Cptmeme/Nanoleaf-Shapes-controller/hardware/render/rev-b-bottom.png

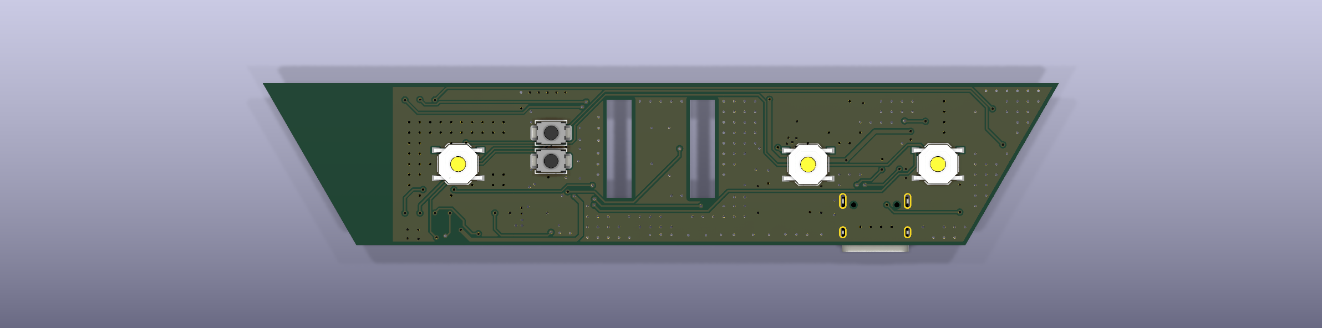
hardware/render/rev-b-bottom.png
