Cptmeme/Nanoleaf-Shapes-controller/hardware/render/rev-b-iso.png

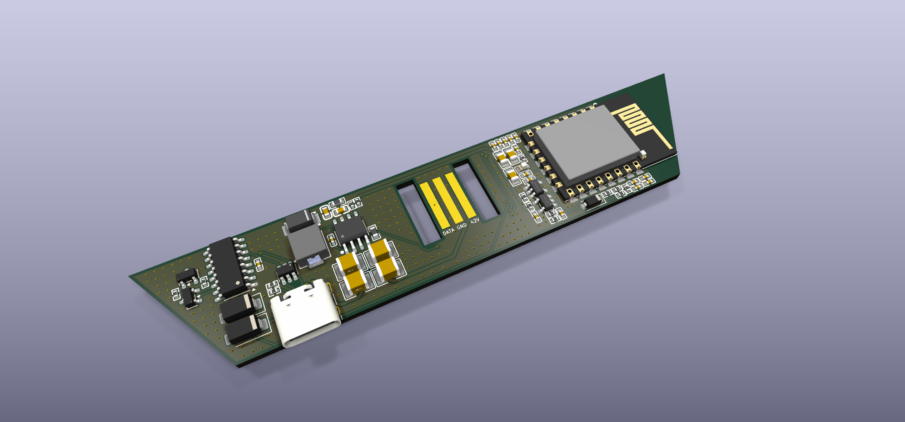
hardware/render/rev-b-iso.png
