Cptmeme/Nanoleaf-Shapes-controller/hardware/render/rev-b-top.png

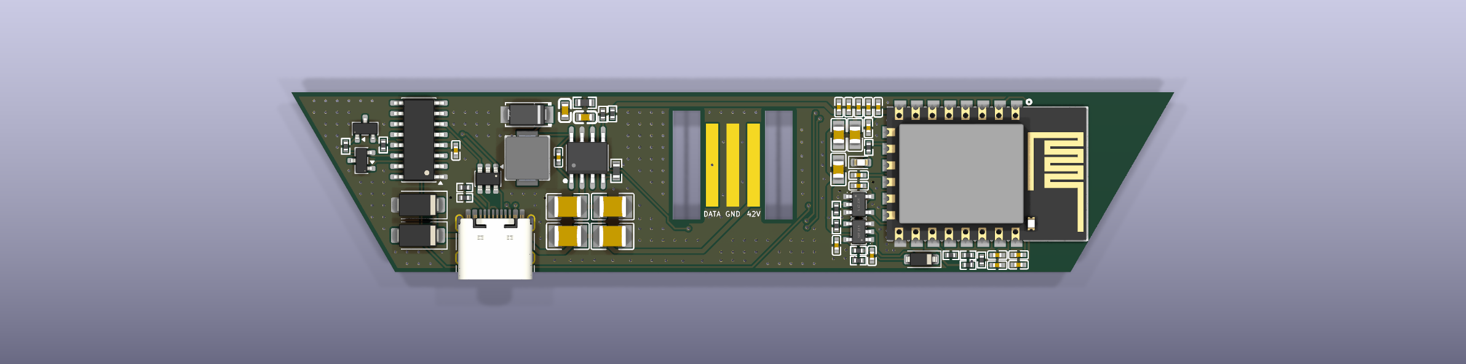
hardware/render/rev-b-top.png
