Cptmeme/Nanoleaf-Shapes-controller/hardware/fab/pcbway/bom_pcbway.xlsx

Item # | Designator | Qty | Manufacturer Part Number | Manufacturer | Description / Value | Package / Footprint | Type | Supplier | Supplier Part Number | Your Instructions / Notes
1 | C1,C2,C3,C11 | 4 |  |  | 2.2uF 100V | C1210 | SMD | LCSC | C5449052
2 | C4,C5,C6,C7,C8,C9,C10,C18,C19,C20,C22,C23,C24,C26 | 14 |  |  | 100nF 16V | C0402 | SMD | LCSC | C1525
3 | C12 | 1 |  |  | 330pF | C0603 | SMD | LCSC | C1664
4 | C13 | 1 |  |  | 47nF | C0603 | SMD | LCSC | C1622
5 | C14,C15,C16 | 3 |  |  | 22uF 25V | C0805 | SMD | LCSC | C45783
6 | C17 | 1 |  |  | 220pF | C0402 | SMD | LCSC | C1530
7 | C21 | 1 |  |  | 1uF | C0402 | SMD | LCSC | C52923
8 | D1,D5 | 2 | SS210 | MDD | 100V/2A Schottky | SMA_L4.3-W2.6-LS5.2-RD | SMD | LCSC | C14996
9 | D2 | 1 |  |  | D | D_SOD-123 | SMD | LCSC | C81598
10 | D3 | 1 | SMAJ48A | LRC | SMAJ48A | D_SMA | SMD | LCSC | C41376401
11 | D4 | 1 | KT-0603W | Hubei KENTO Elec | LED | LED_0603_1608Metric | SMD | LCSC | C2290
12 | J3 | 1 | TYPE-C-31-M-12 | Korean Hroparts Elec | USB_C_Receptacle_USB2.0_16P | USB_C_Receptacle_HRO_TYPE-C-31-M-12 | THT | LCSC | C165948
13 | L1 | 1 |  |  | 33uH >2A sat | IND-SMD_L5.2-W5.2_YSPI0530 | SMD | LCSC | C20417191
14 | Q1,Q2 | 2 | MMBT3904 | Jiangsu Changjing | MMBT3904 | SOT-23 | SMD | LCSC | C7420353
15 | R1 | 1 |  |  | 2.2k | R0402 | SMD | LCSC | C25879
16 | R6,R10,R17 | 3 |  |  | 1k | R0402 | SMD | LCSC | C11702
17 | R11,R12 | 2 | 0402WGF5101TCE | UNI-ROYAL | 5.1k | R0402 | SMD | LCSC | C25905
18 | R7,R9,R13,R14,R16 | 5 |  |  | 10k | R0402 | SMD | LCSC | C25744
19 | R15 | 1 | 0402WGF1003TCE | UNI-ROYAL | 100k | R0402 | SMD | LCSC | C25741
20 | R2 | 1 |  |  | 47k | R0402 | SMD | LCSC | C25792
21 | R3 | 1 |  |  | 15k | R0402 | SMD | LCSC | C25756
22 | R4 | 1 |  |  | 3k | R0603 | SMD | LCSC | C4211
23 | R5 | 1 |  |  | 330k | R0603 | SMD | LCSC | C23137
24 | R8 | 1 |  |  | 220 | R0402 | SMD | LCSC | C25091
25 | SW1,SW2 | 2 | TS-1088-AR02016 | XUNPU(讯普) | RESET | SW_SPST_TS-1088-xR020 | SMD | LCSC | C720477
26 | SW3,SW4,SW6 | 3 | TS-1187A-B-A-B | XKB Enterprise | USER BUTTON | SW_Push_1P1T_XKB_TS-1187A | SMD | LCSC | C318884
27 | U1 | 1 | TPS54360DDAR | TI(德州仪器) | TPS54360DDAR | SOIC-8_L5.0-W4.0-P1.27-LS6.0-BL-EP2.0 | SMD | LCSC | C44377
28 | U2 | 1 | ESPC5-12 | DOIT | ESPC5-12 | WT0132C6-S5 | SMD | LCSC | C52139916
29 | U3,U4 | 2 | 74LVC1G125GV | MDD(辰达半导体) | 74LVC1G125GV_C52140413 | SOT-23-5_L3.0-W1.7-P0.95-LS2.8-BR | SMD | LCSC | C52140413
30 | U5 | 1 | CH340C | WCH(Jiangsu Qin Heng) | CH340C | SOIC-16_3.9x9.9mm_P1.27mm | SMD | LCSC | C84681
31 | U6 | 1 | USBLC6-2SC6 | Hgsemi | USBLC6-2SC6 | SOT-23-6 | SMD | LCSC | C2827654
