Cptmeme/Nanoleaf-Shapes-controller/hardware/mechanical/board_mock_full.stl

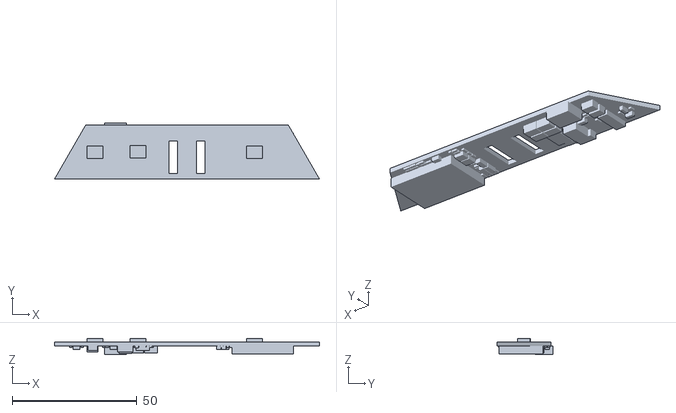
[picture p10: CAD file, 2026-10-17]
hardware/mechanical/board_mock_full.stl
106.3 x 22.5 x 6.60
