Cptmeme/Nanoleaf-Shapes-controller/hardware/mechanical/case_v1_working/enclosure_lid.stl

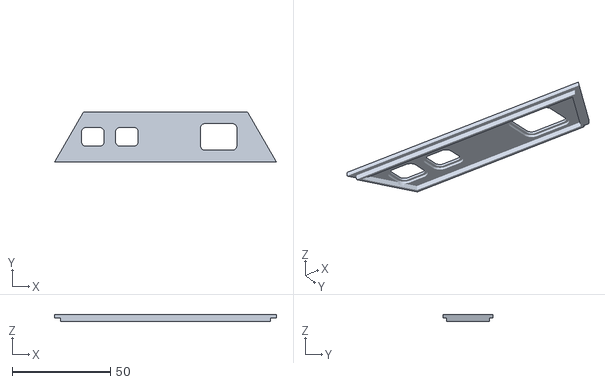
[picture p11: CAD file, 2026-10-17]
hardware/mechanical/case_v1_working/enclosure_lid.stl
113.0 x 25.6 x 3.45
