Cptmeme/Nanoleaf-Shapes-controller/hardware/mechanical/enclosure_tray_comb.stl

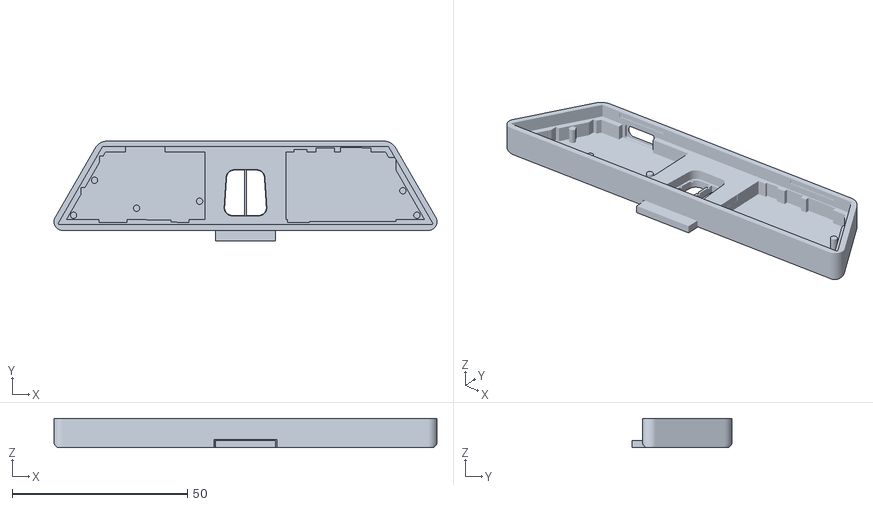
[picture p12: CAD file, 2026-11-11]
hardware/mechanical/enclosure_tray_comb.stl
109.3 x 28.6 x 8.40
