Cptmeme/Nanoleaf-Shapes-controller/hardware/mechanical/case_v1_working/button_SW6.stl

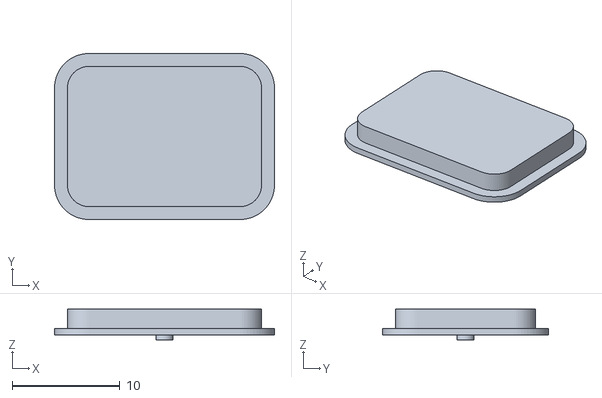
[picture p13: CAD file, 2026-10-17]
hardware/mechanical/case_v1_working/button_SW6.stl
20.4 x 15.4 x 2.85
