Cptmeme/Nanoleaf-Shapes-controller/hardware/mechanical/enclosure_tray.stl

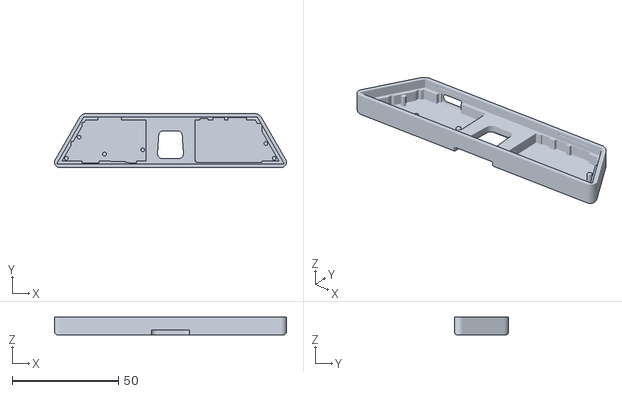
[picture p14: CAD file, 2026-11-11]
hardware/mechanical/enclosure_tray.stl
109.3 x 25.6 x 8.40
