Cptmeme/Nanoleaf-Shapes-controller/hardware/mechanical/button_SW6.stl

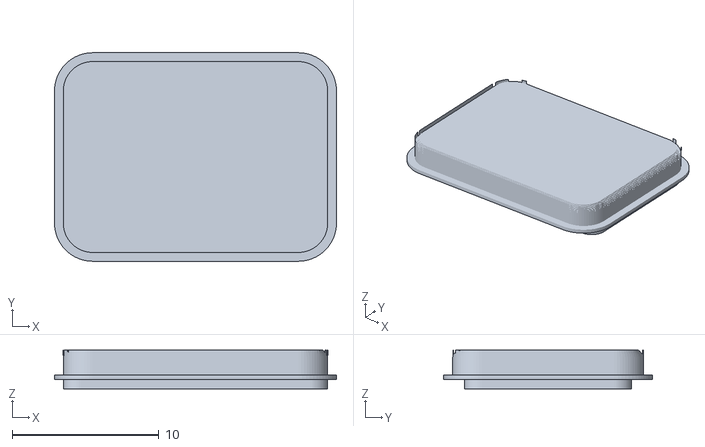
[picture p15: CAD file, 2026-11-10]
hardware/mechanical/button_SW6.stl
19.2 x 14.2 x 2.65
