Cptmeme/Nanoleaf-Shapes-controller/hardware/mechanical/button_SW4.stl

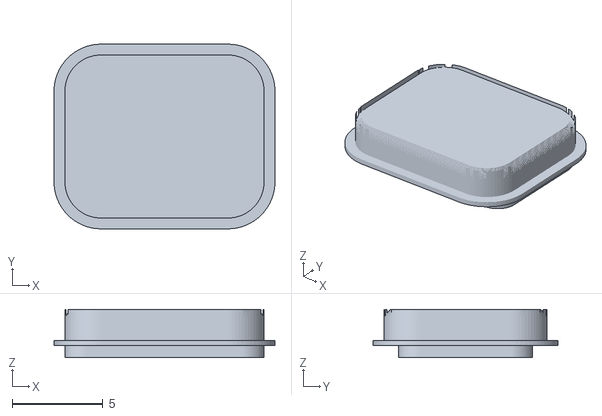
[picture p16: CAD file, 2026-11-10]
hardware/mechanical/button_SW4.stl
12.2 x 10.2 x 2.65
