Cptmeme/Nanoleaf-Shapes-controller/hardware/mechanical/button_SW3.stl

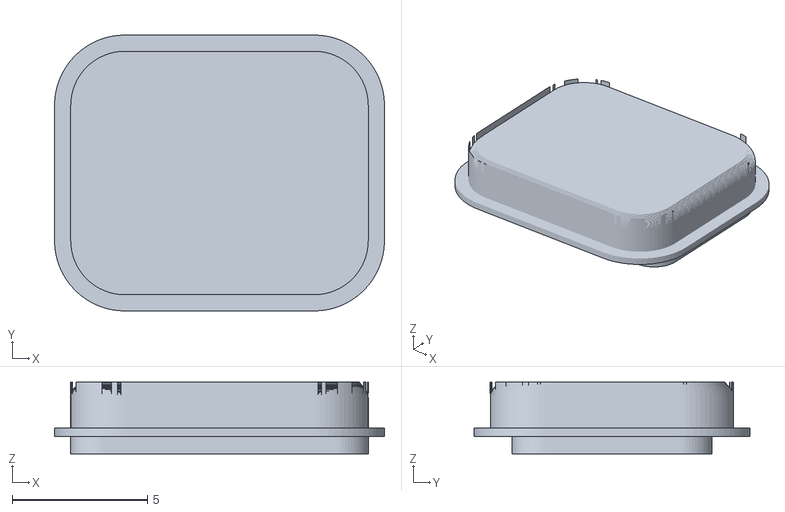
[picture p17: CAD file, 2026-11-10]
hardware/mechanical/button_SW3.stl
12.2 x 10.2 x 2.65
