Cptmeme/Nanoleaf-Shapes-controller/hardware/mechanical/enclosure_lid.stl

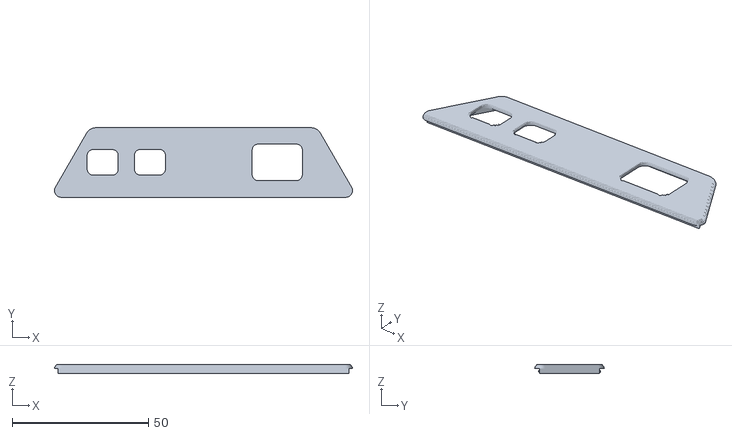
[picture p18: CAD file, 2026-11-10]
hardware/mechanical/enclosure_lid.stl
109.3 x 25.6 x 3.45
