Cptmeme/Nanoleaf-Shapes-controller/hardware/mechanical/pocket_test_c010.stl

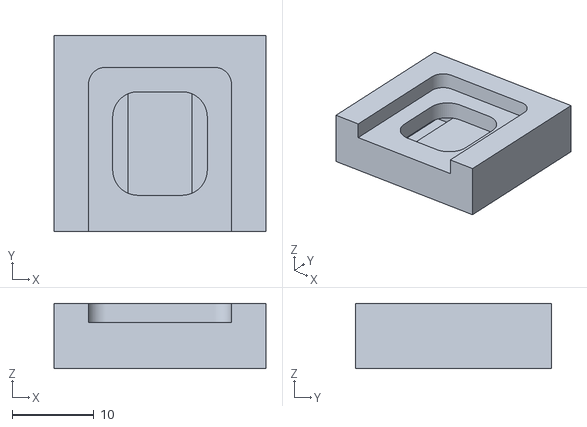
[picture p19: CAD file, 2026-10-17]
hardware/mechanical/pocket_test_c010.stl
26.0 x 24.0 x 8.00
