Cptmeme/Nanoleaf-Shapes-controller/hardware/mechanical/pocket_test_upper_c010.stl

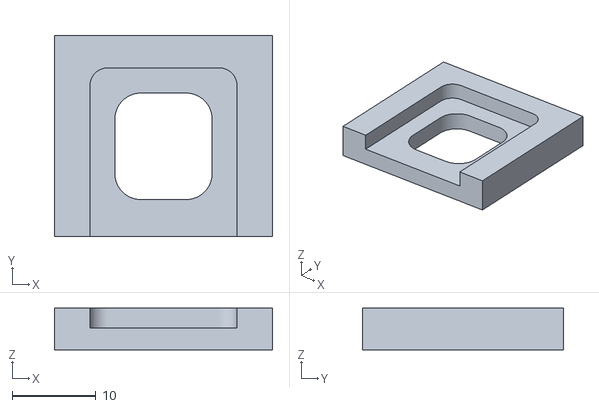
[picture p20: CAD file, 2026-10-17]
hardware/mechanical/pocket_test_upper_c010.stl
26.0 x 24.0 x 4.95
