Cptmeme/Nanoleaf-Shapes-controller/hardware/mechanical/pocket_test_lower.stl

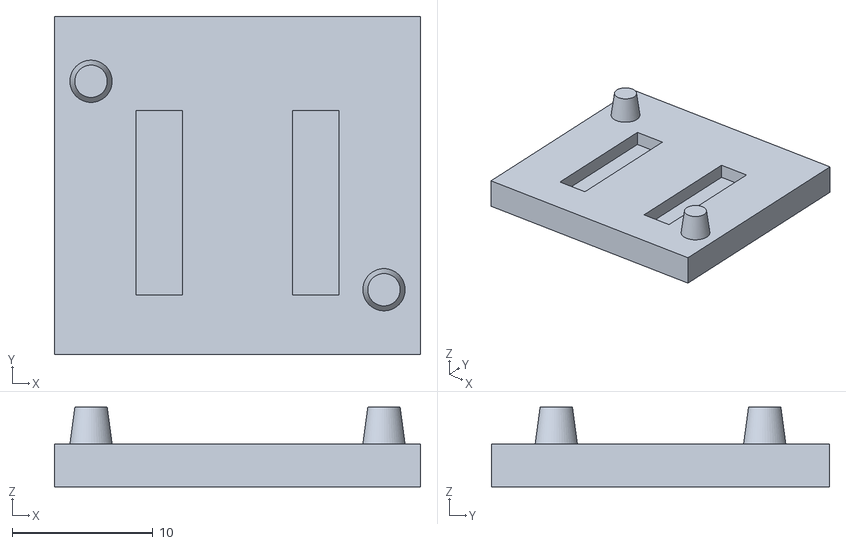
[picture p21: CAD file, 2026-10-17]
hardware/mechanical/pocket_test_lower.stl
26.0 x 24.0 x 5.65
