Cptmeme/Nanoleaf-Shapes-controller/hardware/mechanical/board_mock_front.stl

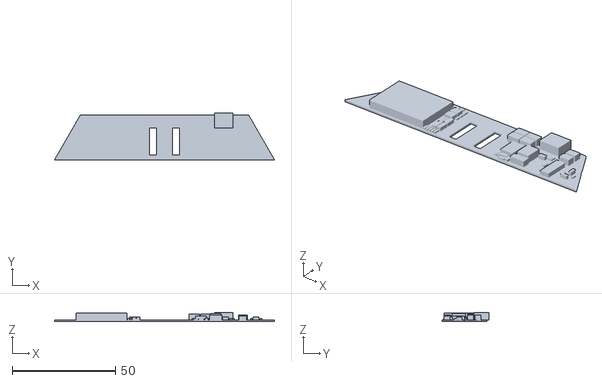
[picture p22: CAD file, 2026-10-17]
hardware/mechanical/board_mock_front.stl
106.3 x 22.5 x 4.30
