Cptmeme/Nanoleaf-Shapes-controller/hardware/mechanical/board_mock_back.stl

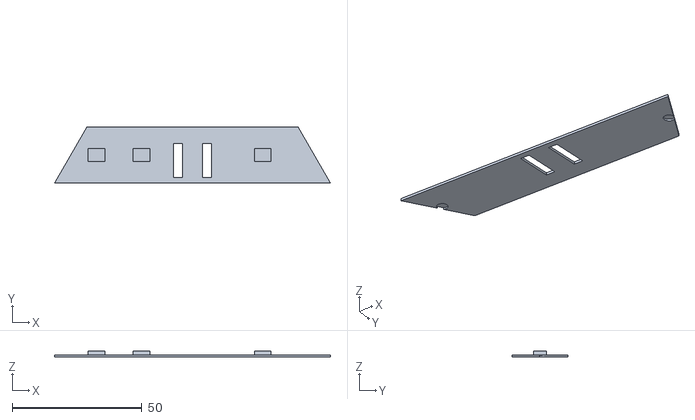
[picture p23: CAD file, 2026-10-17]
hardware/mechanical/board_mock_back.stl
106.3 x 21.7 x 2.30
