Cptmeme/Nanoleaf-Shapes-controller/(list of files, cad)

Other CAD files:
hardware/mechanical/case_v1_working/enclosure_tray.stl
hardware/mechanical/pocket_test_lower_c010.stl
hardware/mechanical/pocket_test.stl
hardware/mechanical/pocket_test_upper.stl
