Cptmeme/Nanoleaf-Shapes-controller/hardware/nanoleaf_shapes.kicad_pcb

## KiCad design hardware/nanoleaf_shapes.kicad_pcb (2026-11-11)

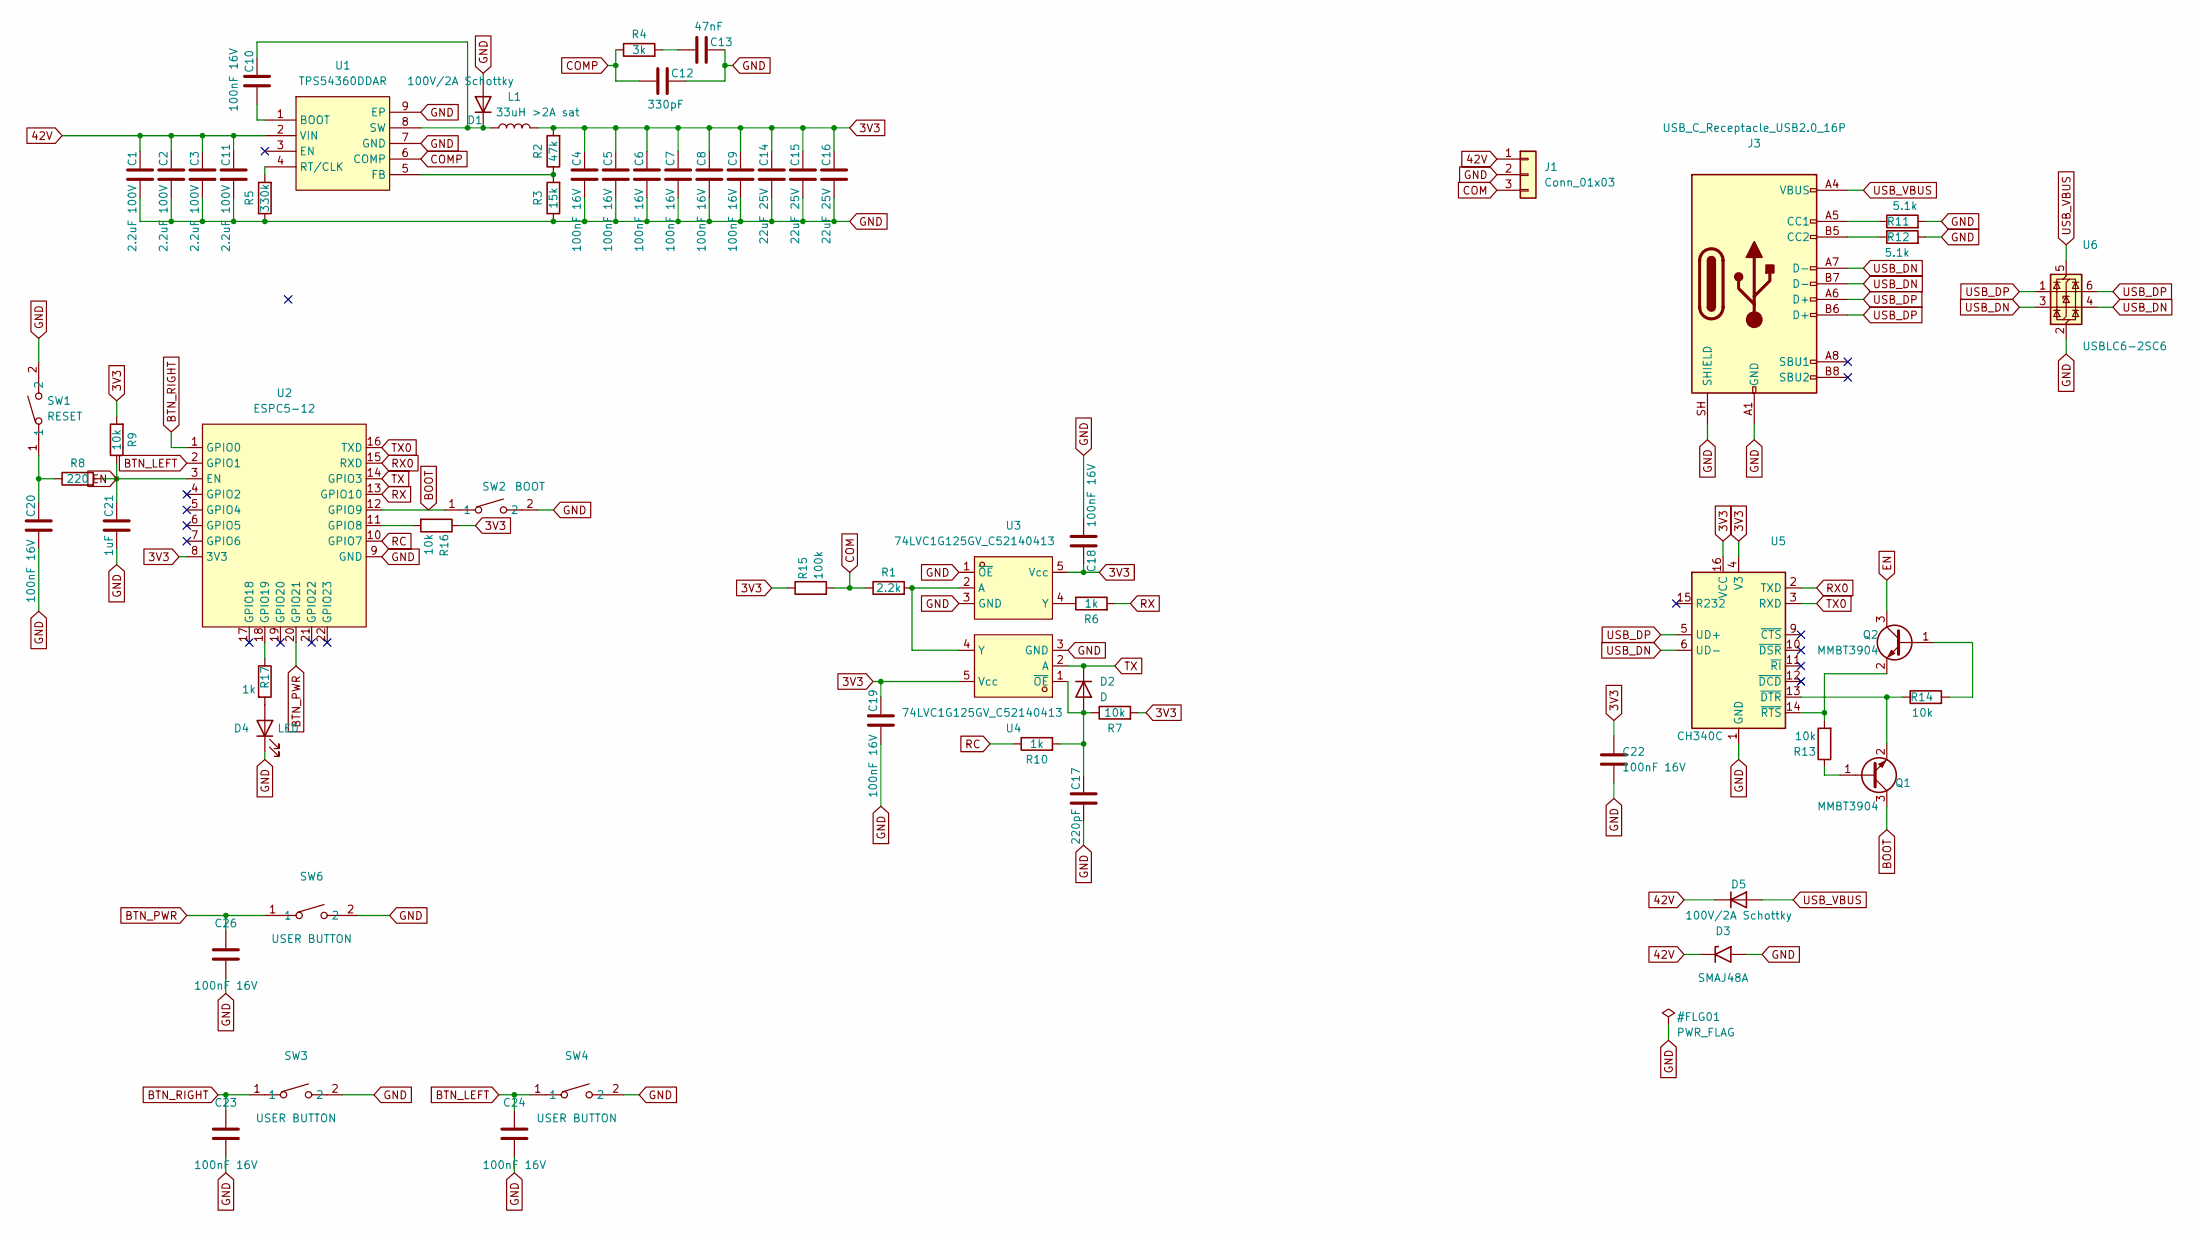
[picture p24: schematic nanoleaf_shapes.kicad_sch]

Parts:
C1, C2, C3, C11: 2.2uF 100V; C1210; LCSC C5449052
C4, C5, C6, C7, C8, C9, C10, C18, C19, C20, C22, C23, C24, C26: 100nF 16V; C0402; LCSC C1525
C12: 330pF; C0603; LCSC C1664
C13: 47nF; C0603; LCSC C1622
C14, C15, C16: 22uF 25V; C0805; LCSC C45783
C17: 220pF; C0402; LCSC C1530
C21: 1uF; C0402; LCSC C52923
D1: 100V/2A Schottky; SMA_L4.3-W2.6-LS5.2-RD; LCSC C14996
D2: D; D_SOD-123; LCSC C81598
D3: SMAJ48A; D_SMA; LCSC C41376401
D4: LED; LED_0603_1608Metric; LCSC C2290
D5: 100V/2A Schottky; D_SMA; LCSC C14996
J1: Conn_01x03; Nanoleaf_Linker_Pads
J3: USB_C_Receptacle_USB2.0_16P; USB_C_Receptacle_HRO_TYPE-C-31-M-12; LCSC C165948
L1: 33uH >2A sat; IND-SMD_L5.2-W5.2_YSPI0530; LCSC C20417191
Q1, Q2: MMBT3904; SOT-23; LCSC C7420353
R1: 2.2k; R0402; LCSC C25879
R2: 47k; R0402; LCSC C25792
R3: 15k; R0402; LCSC C25756
R4: 3k; R0603; LCSC C4211
R5: 330k; R0603; LCSC C23137
R6, R10, R17: 1k; R0402; LCSC C11702
R7, R9, R13, R14, R16: 10k; R0402; LCSC C25744
R8: 220; R0402; LCSC C25091
R11, R12: 5.1k; R0402; LCSC C25905
R15: 100k; R0402; LCSC C25741
SW1: RESET; SW_SPST_TS-1088-xR020; MPN TS-1088-AR02016; LCSC Part C720477
SW2: BOOT; SW_SPST_TS-1088-xR020; MPN TS-1088-AR02016; LCSC Part C720477
SW3, SW4, SW6: USER BUTTON; SW_Push_1P1T_XKB_TS-1187A; LCSC C318884
U1: TPS54360DDAR; SOIC-8_L5.0-W4.0-P1.27-LS6.0-BL-EP2.0; MPN TPS54360DDAR; LCSC Part C44377
U2: ESPC5-12; WT0132C6-S5; MPN ESPC5-12; LCSC Part C52139916
U3, U4: 74LVC1G125GV_C52140413; SOT-23-5_L3.0-W1.7-P0.95-LS2.8-BR; MPN 74LVC1G125GV; LCSC Part C52140413
U5: CH340C; SOIC-16_3.9x9.9mm_P1.27mm; LCSC C84681
U6: USBLC6-2SC6; SOT-23-6; LCSC C2827654

Connections:
3V3: C4.1, C5.1, C6.1, C7.1, C8.1, C9.1, C14.1, C15.1, C16.1, C18.1, C19.1, C22.1, L1.2, R2.2, R7.2, R9.2, R15.1, R16.1, U2.8 (3V3), U3.5 (Vcc), U4.5 (Vcc), U5.4 (V3), U5.16 (VCC)
42V: C1.1, C2.1, C3.1, C11.1, D3.1 (A1), D5.1 (K), J1.1, U1.2 (VIN)
BOOT: Q1.3 (C), SW2.1, U2.12 (GPIO9)
BTN_LEFT: C24.1, SW4.1, U2.2 (GPIO1)
BTN_PWR: C26.1, SW6.1, U2.20 (GPIO21)
BTN_RIGHT: C23.1, SW3.1, U2.1 (GPIO0)
COM: J1.3, R1.1, R15.2
COMP: C12.2, R4.1, U1.6 (COMP)
DTR: Q1.2 (E), R14.1, U5.13 (~DTR)
DTR_B: Q1.1 (B), R13.1
EN: C21.1, Q2.3 (C), R8.2, R9.1, U2.3 (EN)
GND: C1.2, C2.2, C3.2, C4.2, C5.2, C6.2, C7.2, C8.2, C9.2, C11.2, C12.1, C13.1, C14.2, C15.2, C16.2, C17.2, C18.2, C19.2, C20.2, C21.2, C22.2, C23.2, C24.2, C26.2, D1.2 (A), D3.2 (A2), D4.1 (K), J1.2, J3.A1 (GND), J3.A12 (GND), J3.B1 (GND), J3.B12 (GND), J3.SH (SHIELD), R3.1, R5.1, R11.2, R12.2, SW1.2, SW2.2, SW3.2, SW4.2, SW6.2, U1.7 (GND), U1.9 (EP), U2.9 (GND), U3.1 (~OE), U3.3 (GND), U4.3 (GND), U5.1 (GND), U6.2 (GND)
LED: R17.1, U2.18 (GPIO19)
LED_A: D4.2 (A), R17.2
unnamed: C13.2, R4.2
unnamed: C20.1, R8.1, SW1.1
unnamed: C10.1, D1.1 (K), L1.1, U1.8 (SW)
unnamed: C17.1, D2.2 (A), R7.1, R10.2, U4.1 (~OE)
unnamed: C10.2, U1.1 (BOOT)
unnamed: R2.1, R3.2, U1.5 (FB)
unnamed: R5.2, U1.4 (RT/CLK)
unnamed: R1.2, U3.2 (A), U4.4 (Y)
unnamed: R6.1, U3.4 (Y)
PAD11: R16.2, U2.11 (GPIO8)
RC: R10.1, U2.10 (GPIO7)
RTS: Q2.2 (E), R13.2, U5.14 (~RTS)
RTS_B: Q2.1 (B), R14.2
RX: R6.2, U2.13 (GPIO10)
RX0: U2.15 (RXD), U5.2 (TXD)
TX: D2.1 (K), U2.14 (GPIO3), U4.2 (A)
TX0: U2.16 (TXD), U5.3 (RXD)
USB_CC1: J3.A5 (CC1), R11.1
USB_CC2: J3.B5 (CC2), R12.1
USB_DN: J3.A7 (D-), J3.B7 (D-), U5.6 (UD-), U6.3 (I/O2), U6.4 (I/O2)
USB_DP: J3.A6 (D+), J3.B6 (D+), U5.5 (UD+), U6.1 (I/O1), U6.6 (I/O1)
USB_VBUS: D5.2 (A), J3.A4 (VBUS), J3.A9 (VBUS), J3.B4 (VBUS), J3.B9 (VBUS), U6.5 (VBUS)

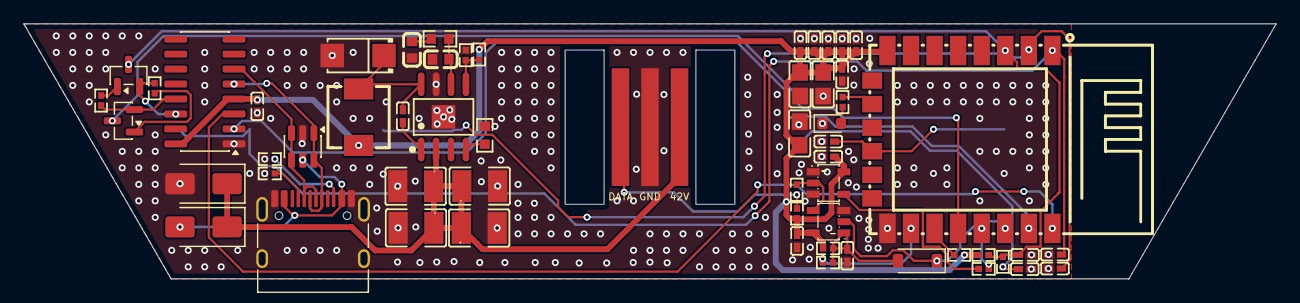
[picture p25: board nanoleaf_shapes.kicad_pcb from above]

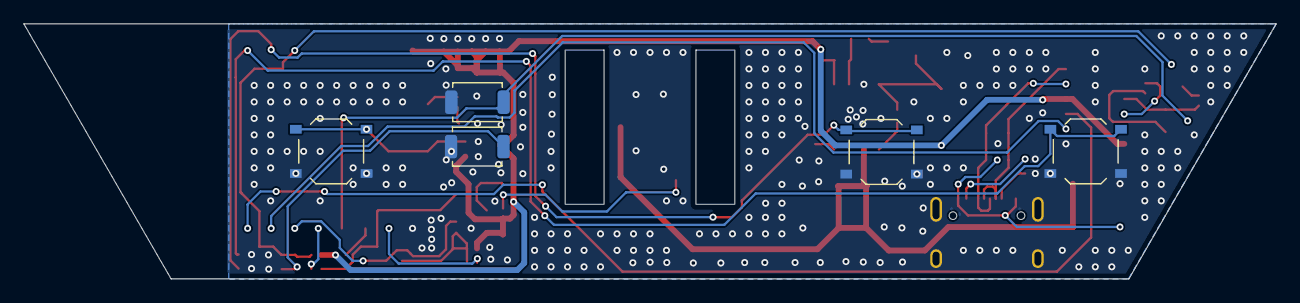
[picture p26: board nanoleaf_shapes.kicad_pcb from below]

Board: 2 copper layers, 106.3 x 21.7 mm, 63 parts (5 on the bottom side), 36 nets.
