Cptmeme/Nanoleaf-Shapes-controller/(commit log)

2026-09-26 Add ESP-IDF bring-up firmware for the interface board
    - LeafBus panel bus master: enumeration, C0 polling, colour push, touch
    - pin auto-detection through the on-board U4/U3 loopback (pinscan)
    - Wi-Fi console (nc nanoleaf-bus.local 23), status page, OTA with rollback
    - DDP receiver for WLED/LedFx/xLights, touch light mode, auto-enumeration
    - `download` command: reboot into the ROM bootloader without BOOT/EN
    Verified on an ESPC5-12 (ESP32-C5) board with 9 Mini Triangles in chain,
    fork and ring layouts. C0 replies come in layout order while E0 chunks
    are reversed, contrary to LeafBus PROTOCOL.md section 5.3.
    [partitions.csv]
2026-09-26 Add documentation and the WLED integration
    - README: hardware, verified module pinout, connectors, power and safety,
    flashing, known rev A issues
    - firmware/README: build, flash, console commands, Wi-Fi, OTA, DDP
    - wled/: patch adding a native "Nanoleaf Shapes" LED output to WLED
    (based on WLED 961961fd), build script and documentation
    - docs/protocol-notes: panel bus behaviour measured on real panels,
    including the C0 reply order correction to LeafBus PROTOCOL.md
2026-09-26 README: credit Christian Panton, announce rev B
    - credit Christian Panton's nanoleaf-ctrl-pt1 write-up and schematics,
    which the board's PCB schematic is based on
    - rev B is in development: fixes the rev A issues and clips onto a panel
    like the original controller instead of using a cut flex linker
2026-09-26 Move KiCad and fabrication files into hardware/
    The KiCad project, Gerbers and JLCPCB assembly files now live in hardware/,
    next to firmware/, wled/ and docs/. Relative paths inside the KiCad project
    (the Gerbers/ output directory) are unchanged; the schematic netlist and
    PCB footprints were re-exported from the new location to check.
    README title follows the repository's new name, Nanoleaf Shapes controller.
    [jlc_bom.csv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]
2026-09-26 Remove the schematic export again
    d25c83d re-added "Nanoleaf Shapes Interface Board.html/.pdf" by accident;
    they had been deleted on purpose. Keep them out via .gitignore.
2026-09-26 README: flex linker wire colours
    Thick red is 42 V, the bare wire is GND and thin blue is DATA. The
    continuity and voltage checks stay, in case colours differ per batch.
2026-09-26 Add a WLED build for the ESP32-C6 module, clean Gerbers zip
    - wled/0002: esp32c6_nanoleaf environment for the WT0132C6-S5, the module
    the footprint is drawn for (TX GPIO3, RX GPIO10, BOOT GPIO9, DIO flash).
    Builds; untested on hardware
    - build.sh takes the environment as a second argument and prints the
    chip's bootloader offset (0x2000 on the C5, 0x0 on the C6)
    - READMEs: per-module builds and flash commands; ESP32-C6 download mode
    needs GPIO8 high, which rev A leaves unconnected
    - Gerbers.zip rebuilt without the macOS metadata entries. Contents are
    byte-identical to the Gerber files, and their geometry matches a fresh
    export from the current PCB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
2026-09-26 Panel bus: react to hot-plugs straight away
    Re-enumerate as soon as a poll reply shows a change, instead of after a
    2 s hold-off. A change is a trailing CC, pairs from panels that were never
    enumerated (the whole trailing burst is read now, not one byte), or three
    short replies in a row (previously only a warning after 20). One second
    after each hot-plug, enumerate again for panels that were still starting
    up. Enumerations that come back to back are spaced out from 250 ms up to
    the stock controller's 3 s.
    Also for the Matter firmware: extern "C" guards, and an enumeration
    counter so users can re-apply their state after a re-enumeration.
    The hot-plug changes build but are not yet tested on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
    [panelbus.c, panelbus.h]
2026-09-26 Add Matter-over-Thread firmware
    matter-over-thread/ builds with esp-matter v1.5 for the ESP32-C5 and
    ESP32-C6. The panels appear as one Extended Color Light (on/off,
    brightness, hue/saturation, xy, colour temperature), plus an On/Off
    Plug-in Unit that runs a moving rainbow. It shares the panel bus engine
    with the ESP-IDF firmware. Commissioning is over BLE with esp-matter's
    test codes; the README lists them, so no serial log is needed.
    The light is commissioned and working on the ESP32-C5 board. The rainbow
    switch is not yet tested on hardware.
    [partitions.csv]
2026-09-26 README: add the Matter firmware throughout, credit esp-matter
    The firmware table gets a Matter column and a network row. The power
    notes now cover every radio, the flashing section covers Matter updates
    and switching firmwares, and the licence covers the Matter firmware.
    Credits esp-matter and the Matter SDK.
2026-09-29 Add WLED usermod version of the Nanoleaf Shapes bus driver
    Restructures the TYPE_LEAFBUS core patch as an out-of-tree usermod, so
    driving the panels from WLED no longer needs changes to WLED itself.
    The protocol half is ported unchanged from wled00/bus_leafbus.cpp:
    transactions with echo stripping, enumeration with layout-string
    stability checking, the 50 ms C0 poll, hot-plug re-enumeration, reversed
    bulk-push chunk order, and the automatic 2D ledmap built from
    leafbus_geometry.h (copied verbatim).
    What changed:
    - frames are taken in handleOverlayDraw() instead of Bus::show(), with a
    non-blocking lock so the render path never waits on the bus
    - pins move to usermod settings and PinOwner: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
    [leafbus_geometry.h, nanoleaf_shapes.cpp]
2026-09-30 README: add a demo video
    A short clip of the rev A board driving nine Mini Triangles, as a looping
    GIF preview that links to an MP4. Both are re-encoded from the phone
    recording without audio, location, device or date metadata.
2026-09-30 README: LeafBus runs on the board too
    Lists MyrikLD's original MicroPython firmware as a fourth option, with
    the three changes it needs here: MicroPython for the C5 or C6, this
    board's bus pins, and open_drain=False (the buffers release the line,
    and the open-drain switch writes an original-ESP32 register). Not yet
    tested on the board. The credits now name the firmware as well.
2026-09-30 WLED: split into usermod and core patch, recommend the usermod
    wled/ now has two folders: usermod/nanoleaf_shapes (no changes to WLED,
    recommended) and core-patch (the original patched build, the one tested
    on the rev A board). A short wled/README.md compares them, and the main
    README points to the usermod.
    The usermod readme gets the steps it was missing: where to put the
    folder (copy into WLED's usermods/, or a symlink:// path to this repo)
    and a C6 environment. It also fixes the LED type, which was
    TYPE_SK6812; WLED only has TYPE_SK6812_RGBW, so the documented build
    failed. With that fixed, the usermod builds against WLED 961961fd for
    the ESP32-C5 (69 % flash) and ESP32-C6 (85 %). It has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
2026-09-30 Panel bus: catch panels added while running
    A panel plugged in while the controller ran stayed unclaimed (dim white)
    for 30 s and more: no usable CC hot-plug marker arrived, yet a fresh
    00 + 80, such as after a reset, claimed it at once. The poll task now
    re-reads the layout once a second and re-enumerates when it differs from
    the enumerated one. That replaces the one-off settle enumeration after a
    hot-plug.
    Verified on the ESP32-C5 board with the Matter firmware: an added panel
    joins within 1-2 s, removals are handled, and the check makes no panel
    blink.
    [panelbus.c]
2026-09-30 Matter: keep the brightness, and let a colour stop the rainbow
    OnLevel and StartUpCurrentLevel were 128, copied from esp-matter's light
    example, so every plain "on" and every power-up went to 50 %. Both are
    now null, which means "the previous level". Neither value was stored in
    NVS, so paired boards pick this up without being paired again.
    Every ColorControl command except StopMoveStep now switches the rainbow
    endpoint off before it runs, so picking a colour shows that colour. It's
    a command hook rather than an attribute callback because esp-matter
    skips attribute callbacks for unchanged values, which would leave the
    rainbow running when the chosen colour equals the current one.
    Both verif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
    [app_main.cpp]
2026-10-03 Sync brightness state on device enumeration
    - Cache brightness configuration locally to ensure consistent state
    - Transmit global brightness command automatically after enumeration
    - Update cached brightness value during manual level adjustments
2026-10-03 Improve panel mapping and bus communication
    - Refactor overlay drawing logic to map render buffers correctly using the pixel indices to handle panel layouts
    - Add open-drain configuration option for the transmission pin to support unbuffered hardware wiring
    - Implement periodic layout checks to detect hot-plugged panels and trigger automatic re-enumeration
    [nanoleaf_shapes.cpp]
2026-10-03 Implement spatial weight calculation and rendering optimisation for shapes
    - Integrate spatial grid transformations and weight mapping tables to sample multiple cells per panel efficiently.
    - Apply gamma correction dynamically during frame processing to match physical LED strip output behaviour.
    - Add asynchronous map recalculation triggers and thread-safe weight updates to prevent rendering thread stalls.
    [leafbus_geometry.h, leafbus_weights.h, nanoleaf_shapes.cpp]
2026-10-17 Implement exponential back-off for layout polling
    - Introduce a back-off cap configuration to limit retry frequency during unanswered layout probes and prevent network congestion.
    - Implement exponential increase of check intervals upon failed responses to optimise resource utilisation during idle states.
    - Reset the polling interval to baseline upon successful layout detection to ensure responsive state updates when devices are active.
2026-10-17 Docs: the LeafBus spec now matches what these panels do
    MyrikLD merged this project's measurements into PROTOCOL.md on 2026-09-27
    and credits them inline, so the README's claim that real panels differ from
    that document is no longer true. Every note in docs/protocol-notes.md is in
    the spec now: the C0 reply order, the 0x20 bit on the power supply panel,
    the 10 marker on the first poll after a release, and the panel centre
    lattice.
    docs/protocol-notes.md stays as the raw record. Two things were fixed there:
    - Section 1 argued against a version of 5.3 that no longer exists. It now
    reads as a record of what was measured rather than a live correction.
    - The section sign meant both documents,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
2026-10-17 Rev B hardware: replaces rev A, not yet verified
    Rev B clips onto a panel like the stock controller instead of connecting
    through a cut flex linker, and fixes the rev A issues listed in the README.
    It replaces rev A in hardware/.
    NOT VERIFIED. No rev B board has been built or powered up. Boards are on
    order. What has been checked is DRC (0 errors, 0 unconnected items), ground
    continuity, a 3D fit check of the enclosure against the KiCad component
    models, and the fabrication files against the board they came from. None of
    that proves the circuit works. Rev A, which is built and working, stays in
    the history at the previous commit.
    Also added:
    - mechanical/ builds the enclosure from the boa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
2026-10-17 README: describe rev B properly
    The rev B section was two bullets written before the board existed. It now
    covers what the board actually is: the trapezoid that clips beside a panel
    on a standard linker, the three pads the linker's springs press on, the
    42 V buck, the ESP-12F footprint and what is fitted in it, the USB-C and
    CH340C that replace the bare serial header, and the case that is generated
    from the board rather than drawn against it.
    The "on order, not yet verified" banner stays at the top of the section, so
    nobody reads it as a working result.
    The JLCPCB ignore rule moves from .gitignore to .git/info/exclude. It did
    not need to be published, and the reasoning behind it even less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
2026-10-17 Drop the superseded 3D prints
    Only the current case is worth shipping. Removed:
    - mechanical/case_v1_working/, the snapshot of the enclosure taken before
    the rounded edges and the snap fit. It was a fallback during that work and
    the work is done. It stays in the history at 11ddc18 if it is ever wanted.
    - the six pocket_test STLs. That test piece proved the linker pocket months
    ago and pocket_test.py regenerates it in seconds, so the prints themselves
    were dead weight.
    The README passages that told you to print those files now say to run the
    script first, and the fallback note points at the commit rather than a
    folder. pocket_test*.stl is gitignored so regenerating it does not dirty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
2026-10-17 README: the case is unfinished and has never met a real board
    The "not verified" banner covered the board but let the case pass as done.
    It is not. No rev B PCB exists, so nothing about the enclosure has been
    checked against anything but KiCad's 3D models, and those models have been
    wrong three times in this project already: U2's origin sits 3.9 mm off its
    own pads, the TS-1187A shipped with no model at all, and a dozen footprints
    draw courtyards that leave their leads outside. Software clearance is a
    prior, not a measurement.
    Both READMEs now say so, and the hardware one lists what to expect trouble
    from on a first print: the snap interference is a guess nobody has felt, the
    button caps cl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
2026-10-17 Implement SVG layout rendering for hardware topology
    - Add a dedicated vector graphics generator module to serialize physical panel geometries, connection points, and root nodes into standardized image formats for spatial verification.
    - Expose an asynchronous HTTP endpoint serving generated assembly graphics with strict caching directives to ensure immediate visual feedback during runtime configuration updates.
    - Integrate interactive preview elements directly into the embedded management interface to render real-time spatial transformations based on persistent rotation parameters.
2026-10-20 README: thank PCBWay for sponsoring the rev B boards
    PCBWay are sponsoring the rev B boards and their assembly, and the order is
    placed. The new section covers what can honestly be judged so far, which is
    the ordering and the support rather than the hardware: replies within
    minutes, the time difference answering questions overnight, a straight
    technical answer on ENIG versus lead free HASL that talked me out of the
    more expensive option, and help cutting the order back to single sided
    assembly.
    It says plainly that the boards have not arrived, so nothing is claimed
    about the PCBs, the assembly or the finish.
2026-11-10 hardware: name the user button nets for where they are
    The three user switches were called BTN_PWR, BTN_UP and BTN_DN after a plan
    of power, brightness up and effect that the firmware no longer follows. The
    names had drifted far enough to be actively misleading: BTN_PWR sat on SW3,
    which is the button furthest from the power one, and reading that off the
    schematic is exactly what put power on the wrong switch when the Matter
    firmware first grew buttons.
    They are on the back of the board and the case shows that face to the room,
    so the view is mirrored and the highest board x is the leftmost button:
    SW6 x 113.90 leftmost, large cap BTN_PWR U2 pad 20 GPIO10
    SW4 x 67.18 mid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
2026-11-10 mechanical: buttons that do not hold their switches closed
    The printed caps left 0.10 mm between their flat underside and the switch
    plunger. Fitted, all three held their switches permanently closed: the
    switch spring pushed each cap up against the lid's step, which lifted the
    lid off its snap beads, so the case bulged and would not click shut. It
    seated fine with the caps left out.
    0.10 mm was less than the error in the three numbers it was made of. The
    switch height is the datasheet's 1.50 against the supplier model's 1.59,
    the board is 1.60 nominal with the fab's tolerance on top, and the switches
    are hand soldered so they stand up on their fillets.
    Clearance is now 0.30 mm, which toler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
2026-11-10 hardware/README: the button rename, and the case as it now stands
    Two things that had drifted from the files.
    The user button section had the old net names and listed the switches in
    board x order, which is backwards from what anybody at the wall sees. It
    now gives both orders side by side, says plainly that the highest x is the
    leftmost button because the switches are on the back, and records why the
    names changed so the next reader does not repeat the mistake.
    The case sections caught up with the enclosure as built: the flange buttons
    that replaced the snap arms, the split corner radii, the larger edge
    fillet, and the snap interference at 0.25 mm.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
2026-11-10 firmware: a reset tool for rev B, whose auto-reset is wired inverted
    idf.py flash does not work on a rev B board, and the way it fails is
    misleading: esptool reports "Invalid head of packet", which reads like a
    bad cable, but the chip is fine and simply never enters the ROM loader.
    Rev B wires the CH340C's handshake lines to the two reset transistors the
    other way round from the DevKitC circuit esptool assumes:
    Q1 collector -> BOOT base <- R13 <- ~DTR emitter <- ~RTS
    Q2 collector -> EN base <- R14 <- ~RTS emitter <- ~DTR
    so esptool's classic_reset asserts BOOT where it means to assert EN.
    Measured against the ROM's own boot: field on the first assembled board:
    DTR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
2026-11-10 matter: power and colour cycle on the three case buttons
    The case switches did nothing. They now drive the light:
    SW6 leftmost, large cap GPIO10 power, toggles the light
    SW4 middle GPIO1 colour cycle back
    SW3 rightmost GPIO0 colour cycle forward
    The cycle is nine fixed colours and then the moving rainbow, wrapping both
    ways, so either button alone walks the whole ring. Stepping onto the
    rainbow leaves the colour attributes alone, so stepping off it puts the
    previous colour straight back rather than resetting to red.
    Like the BOOT button already did, the callbacks write the data model rather
    than the panels, so a colour picked at the wall shows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
2026-11-10 docs: the low nibble of a touch is a magnitude, not a gesture
    Section 2 listed the touch codes as a set whose low nibble "varies with the
    gesture". It does not. Measured with one Hexagon on the rev B board,
    pressing the centre of the front diffuser, five attempts per condition:
    one fingertip, light 2 of 5 registered peak magnitude 1
    one fingertip, firm 1 of 5 registered peak magnitude 2
    whole hand, flat 5 of 5 registered peak magnitude 15
    It follows contact area rather than force, saturates at 15, and decays
    while the touch is held, which is a baseline tracker re-learning a
    stationary finger. A held touch ends because the reading reached zero, not
    because the f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
2026-11-10 matter: brightness on the right button, and hold power to unpair
    Reworks what the three case buttons do, and adds the reset there was no
    other way to reach.
    left, large tap: power hold 10 s: erase the Matter pairing
    middle tap: next colour
    right tap: +10% hold: ramp up to 100%
    The colour cycle is one direction now and wraps past the rainbow, so one
    button still reaches every colour. Brightness steps to the next 10% mark and
    wraps from 100% back to 10%; held, it ramps to the top and keeps whatever
    level it reached when released.
    Holding power erases the pairing because SW1 and SW2 are not fitted on this
    board, so the usual hold-BOOT route doe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
2026-11-10 hardware: rev C, with the faults rev B's bring-up turned up
    Rev C replaces rev B in hardware/, the way rev B replaced rev A. Rev B is
    built and working, so none of this is a redesign: it is the list of things
    that building a board and living with it exposed.
    Auto-reset was wired backwards. The CH340C's DTR and RTS reached the wrong
    transistors, so esptool's standard sequence drove EN and BOOT the wrong way
    round and the board would not enter download mode on its own. U5 pins 13 and
    14 swap, which puts Q1's emitter on DTR with its base on RTS and Q2's the
    other way round, the usual DevKitC arrangement. Stock esptool works instead
    of firmware/tools/revb_reset.py. SW1 and SW2 keep their footpr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
2026-11-11 docs: photos of the board in its printed case, on the panels
    Two shots of the controller clipped to a panel edge and driving the run:
    the whole run lit, and a close-up of the case and its three button caps.
    The case section claimed the case had been printed and fitted to a real
    board, and these are what that looks like.
    Both are straight off a phone, so they are rotated to match their EXIF
    orientation and then stripped of every tag before being committed: the
    originals carried GPS coordinates, the phone model and capture times, and
    this repository is public. Resized to 1600 px on the long edge, which
    takes the pair from 7.5 MB to 0.5 MB. Checked with exiftool and with a
    byte search for "App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
2026-11-11 Fix typo in README.md regarding printer settings
2026-11-11 docs: drop rev A, and keep the generator scripts off GitHub
    Rev A was never something anyone could order and only one board was ever
    made, so documenting it as a thing you might own was noise for everyone
    else. Every rev A reference is gone. Where it was being used as a
    baseline -- "16 mm on rev A", "rev A had the module on the back", the
    whole "Known issues (rev A)" table -- the reasoning is kept and rewritten
    to stand on its own, because it is still why the current board looks the
    way it does.
    The demo video stays. It is the clearest evidence the thing works, and
    its caption now says "an early board" rather than naming a revision.
    Removing rev A exposed sections that were still describin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
2026-11-11 docs: stop naming the generator scripts in the design notes
    They are not published, so every reference was pointing at a file the
    reader does not have. Two "Files" tables listing them are gone, as is the
    runbook for re-running them, and the inline mentions now describe what
    happens rather than which script does it: "43 came from the stitching
    grid", not "43 came from revb_stitch.py".
    Nothing about the board or the case is lost. The reasoning, the
    measurements and the mistakes all stay, because that is what explains why
    the board looks the way it does -- the note at the top now says as much.
    Two things were only documented inside the tables that went, and are put
    back in prose: the linker f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
2026-11-11 hardware: no JLCPCB anywhere, the boards are PCBWay's
    The boards and their assembly are sponsored by PCBWay, so a competitor's
    name has no business being spread through the repository.
    The schematic field holding the part numbers was literally named JLCPCB,
    on 63 symbols, and it carries LCSC codes rather than anything specific to
    an assembler. It is now named LCSC, in the schematic, the board, the
    netlist and the project file. It is not merged into the existing
    "LCSC Part" field, because symbols such as U3 carry both and KiCad will
    not take two properties of the same name.
    Verified rather than assumed: a netlist exported from the renamed
    schematic is identical to the one in the repository,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
2026-11-11 hardware: drop a stray no-connect, and make the check figures true
    Kevin removed a No Connect flag that sat at (62.23, 63.5) mm with no
    pin, wire or symbol anywhere near it -- left behind when pads 11 and 18
    had their flags removed for the pull-up and the status LED. It was
    attached to nothing, and an exported netlist is identical before and
    after, so nothing about the board changes. ERC is now 41 warnings, all
    of them pin_to_pin.
    Both check figures in this file had drifted, and one of them was being
    read as a regression when it was nothing of the sort:
    ERC 33 -> 41 warnings. It has been 41 since the board before this
    one; the number was simply never updated as parts were added.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
2026-11-12 wled: fix enumeration and the 2D map on hexagon and triangle walls
    Found on a real wall of 14 hexagons and 9 triangles, where WLED drove 9
    panels, then a one-panel shift at any count, and never wrote a ledmap.
    The layout reply often began with 0x80, our own layout-detect command,
    relayed back by the panels after send() stops waiting for its echo. It has
    bit 7 set, so it was counted as a panel: 23 enumerated as 24, every pixel
    landed one panel along, pixel 0 drove nothing, and the stored layout was
    unparseable, so no map. A leading 0x80 is now dropped. The usermod had a
    second copy of the problem: layoutChanged() compares node bytes every
    second, so the echo would have re-enumerated it about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
